YCX81/Axdr/原理图.pdf

# VBUS A4 CC1 A5 DP1 A6 DN1 A7 SBU1 A8 VBUS A9

# 防反接&防过压&缓启动

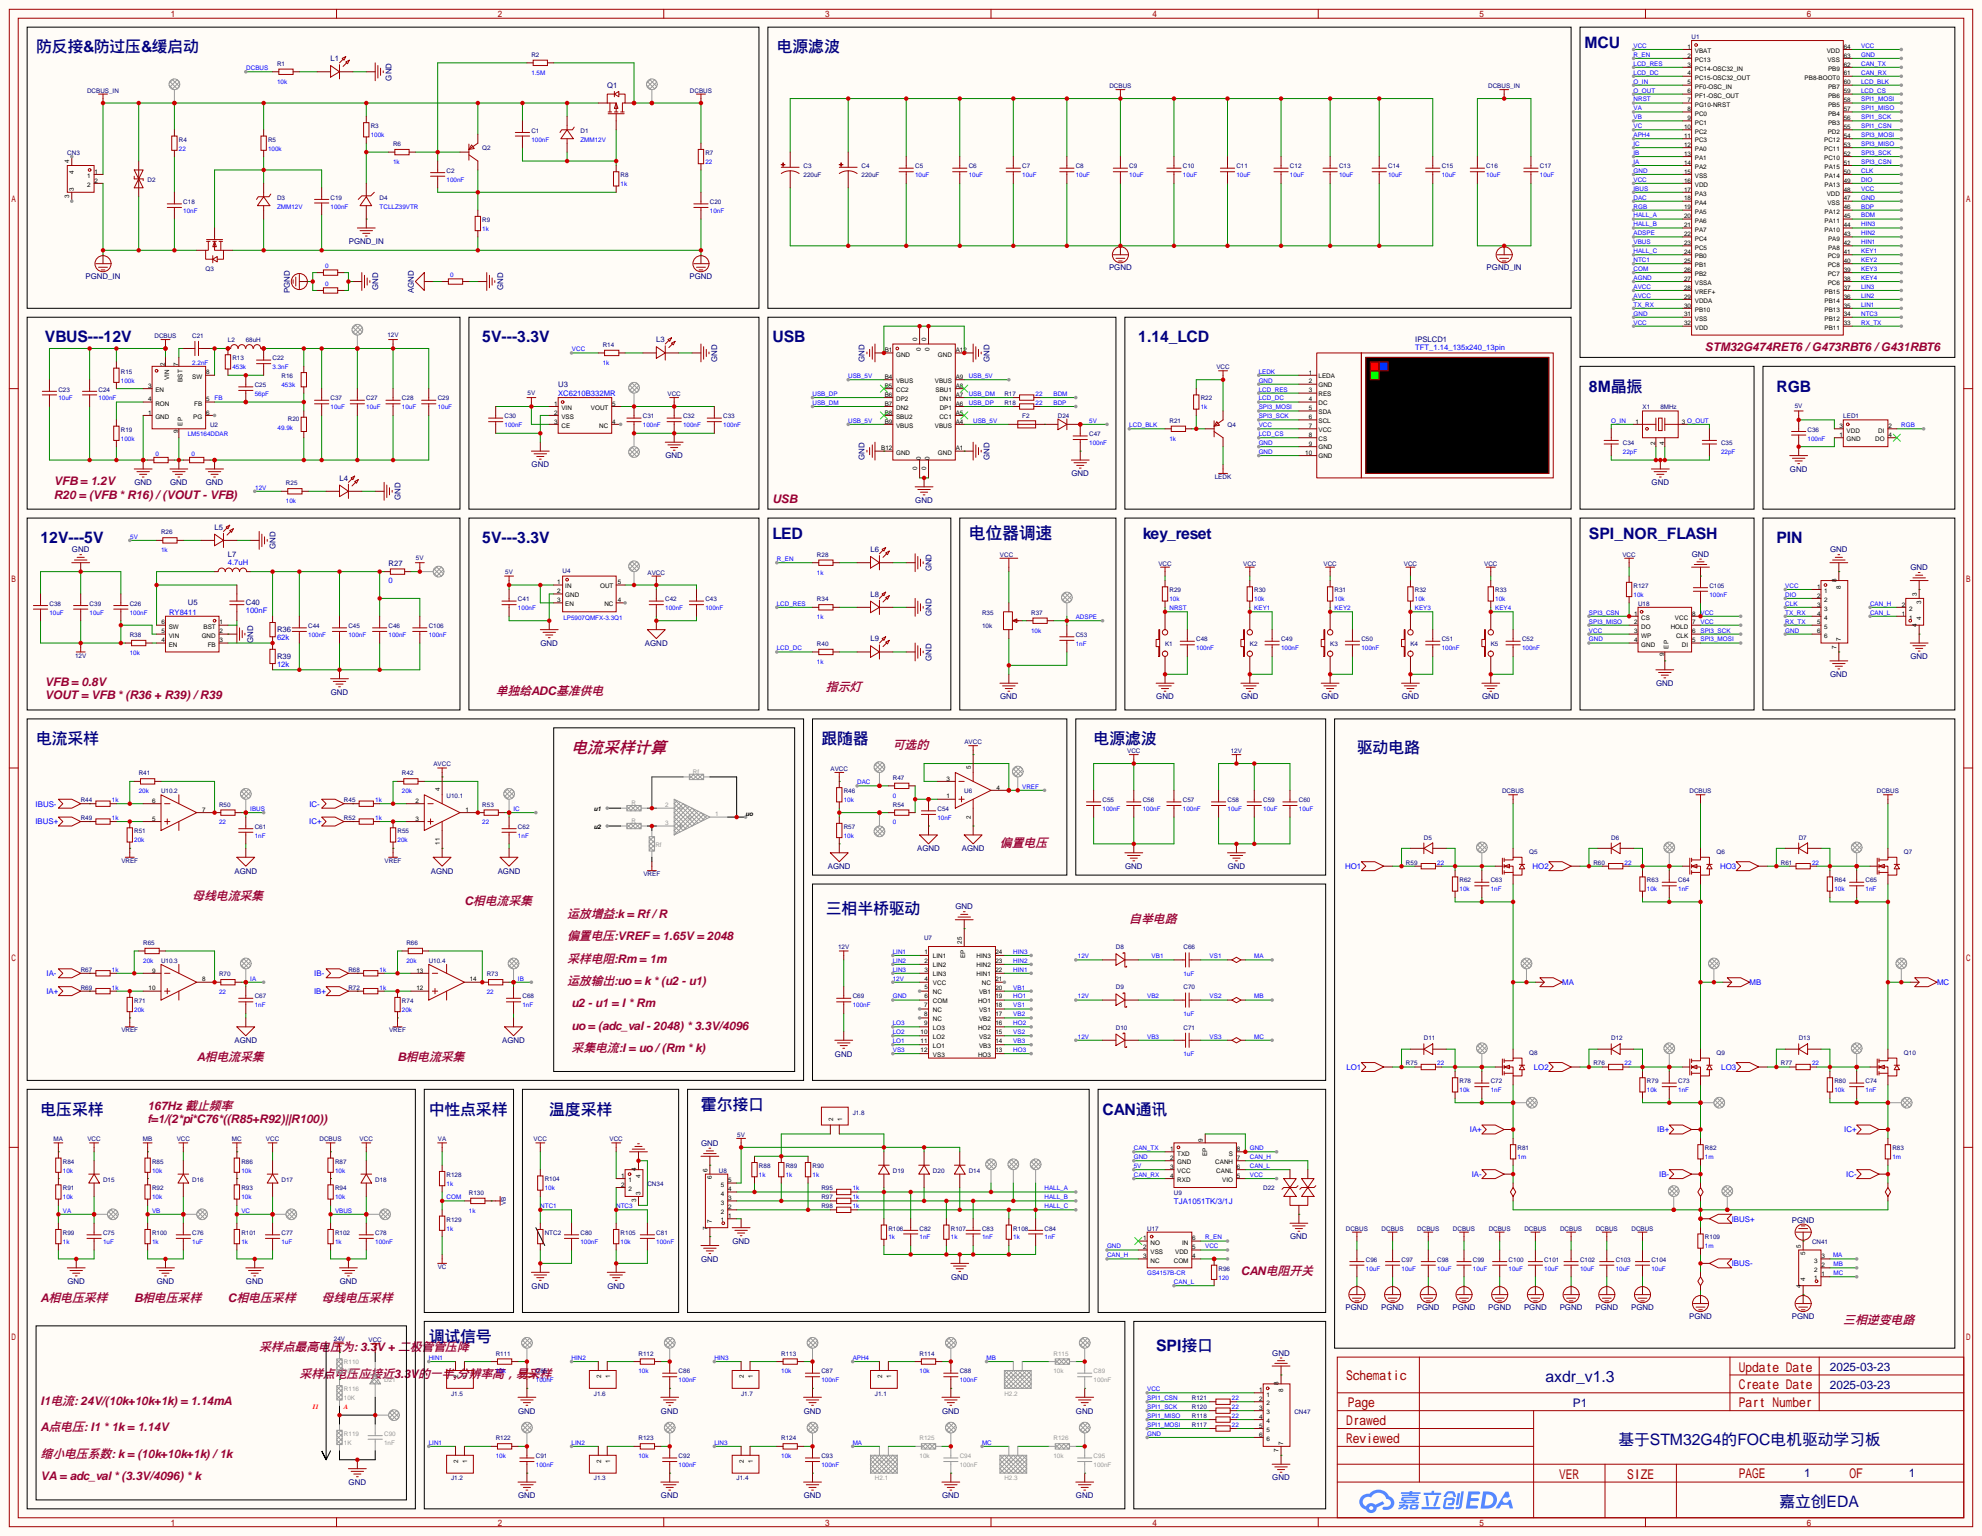
[picture p2: page 1]
