YCX81/Axdr/Core/Src/main.c

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
/* Includes ------------------------------------------------------------------*/
#include "main.h"
#include "adc.h"
#include "dma.h"
#include "fdcan.h"
#include "spi.h"
#include "tim.h"
#include "usart.h"
#include "usb_device.h"
#include "gpio.h"

/* USER CODE BEGIN Includes */
#include "foc_config.h"
#include "foc_math.h"
#include "svpwm.h"
#include "open_loop.h"
#include "foc_ctrl.h"
#include "mt6835.h"
#include "vofa.h"
#include "test_runner.h"
#include <stdio.h>
#include <string.h>
/* USER CODE END Includes */

/* USER CODE BEGIN PM */
#define IQ_STEP_HOLD_MS 3000U

/* USER CODE END PM */


void SystemClock_Config(void);
/**
  * @brief  The application entry point.
  * @retval int
  */
int main(void)
{

  /* MCU Configuration--------------------------------------------------------*/

  /* Reset of all peripherals, Initializes the Flash interface and the Systick. */
  HAL_Init();

  /* Configure the system clock */
  SystemClock_Config();

  /* Initialize all configured peripherals */
  MX_GPIO_Init();
  MX_DMA_Init();
  MX_SPI1_Init();
  MX_TIM1_Init();
  MX_TIM3_Init();
  MX_USB_Device_Init();
  MX_ADC1_Init();
  MX_ADC2_Init();
  MX_USART3_UART_Init();
  MX_FDCAN1_Init();
  MX_SPI3_Init();
  /* USER CODE BEGIN 2 */

  /* Initialize MT6835 encoder via SPI1 */
  mt6835_init(&g_encoder, 7);   /* pole_pairs: adjust to your motor */

#ifdef ENABLE_TESTS
  HAL_Delay(500);  /* wait for USB enumeration */
  test_run_all();
  while (1) { ; } /* halt after tests */
#endif

  /* Initialize FOC controller */
  foc_ctrl_init(&g_foc);

  /* Calibrate ADC zero-current offsets (PWM off, motor still) */
  HAL_ADCEx_Calibration_Start(&hadc1, ADC_SINGLE_ENDED);
  foc_ctrl_calibrate_offsets(&g_foc);

  /* === Encoder zero-point calibration ===
   * Apply Valpha > 0, Vbeta = 0 to align rotor d-axis to alpha (true elec angle = 0)
   * NOT using Vq (which would be 90 degrees off) */

  /* Start PWM manually for calibration */
  HAL_TIM_PWM_Start(&htim1, TIM_CHANNEL_1);
  HAL_TIM_PWM_Start(&htim1, TIM_CHANNEL_2);
  HAL_TIM_PWM_Start(&htim1, TIM_CHANNEL_3);
  HAL_TIMEx_PWMN_Start(&htim1, TIM_CHANNEL_1);
  HAL_TIMEx_PWMN_Start(&htim1, TIM_CHANNEL_2);
  HAL_TIMEx_PWMN_Start(&htim1, TIM_CHANNEL_3);

  /* Apply d-axis voltage directly: Valpha = 15% Vbus, Vbeta = 0 */
  {
    SvpwmOutput_t cal_pwm = svpwm_calculate(VBUS_DEFAULT * 0.15f, 0.0f, VBUS_DEFAULT);
    svpwm_apply(&cal_pwm);
  }

  /* Wait for rotor to settle at electrical angle = 0 */
  HAL_Delay(1000);

  /* Read encoder and set as zero offset */
  mt6835_update(&g_encoder);
  mt6835_set_zero(&g_encoder);

  /* Stop calibration PWM */
  HAL_TIM_PWM_Stop(&htim1, TIM_CHANNEL_1);
  HAL_TIM_PWM_Stop(&htim1, TIM_CHANNEL_2);
  HAL_TIM_PWM_Stop(&htim1, TIM_CHANNEL_3);
  HAL_TIMEx_PWMN_Stop(&htim1, TIM_CHANNEL_1);
  HAL_TIMEx_PWMN_Stop(&htim1, TIM_CHANNEL_2);
  HAL_TIMEx_PWMN_Stop(&htim1, TIM_CHANNEL_3);

  /* Current closed-loop mode with Iq step-response test */
  foc_ctrl_set_mode(&g_foc, FOC_MODE_CURRENT);
  g_foc.id_ref = 0.0f;
  g_foc.iq_ref = 0.05f;
  foc_ctrl_start(&g_foc);

  /* USER CODE END 2 */

  /* Infinite loop */
  /* USER CODE BEGIN WHILE */
  while (1)
  {
    /* USER CODE END WHILE */

    /* USER CODE BEGIN 3 */
    {
      uint32_t step_idx = (HAL_GetTick() / IQ_STEP_HOLD_MS) % 3U;

      if (step_idx == 0U) {
        g_foc.iq_ref = 0.05f;
      } else if (step_idx == 1U) {
        g_foc.iq_ref = 0.10f;
      } else {
        g_foc.iq_ref = 0.15f;
      }
    }
    /* Encoder is read in TIM1 ISR at 20kHz — do NOT call mt6835_update here
     * to avoid SPI race condition with the ISR. */

    /* VOFA+ debug output now handled via USB CDC in TIM1 ISR (vofa_send_from_isr) */
  }
  /* USER CODE END 3 */
}

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
/* USER CODE BEGIN 4 */

/* TIM1 update interrupt callback - called at PWM frequency (20kHz) */
void HAL_TIM_PeriodElapsedCallback(TIM_HandleTypeDef *htim)
{
  if (htim->Instance == TIM1) {
    mt6835_update(&g_encoder);
    foc_ctrl_update(&g_foc);
    vofa_send_from_isr();
  }
}

/* USER CODE END 4 */
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
