YCX81/Axdr/AxDr.ioc

Mcu.UserName=STM32G431RBTx
PA0.Signal=ADC1_IN1
PA1.Signal=ADC1_IN2
PA10.Signal=S_TIM1_CH3
PA11.Signal=USB_DM
PA12.Signal=USB_DP
PA13.Signal=SYS_JTMS-SWDIO
PA14.Signal=SYS_JTCK-SWCLK
PA15.GPIO_Label=SPI3_CS
PA15.Signal=GPIO_Output
PA2.Signal=ADC1_IN3
PA3.Signal=ADC1_IN4
PA6.Signal=ADC2_IN3
PA7.Signal=ADC2_IN4
PA8.Signal=S_TIM1_CH1
PA9.Signal=S_TIM1_CH2
PB1.Signal=ADC1_IN12
PB10.Signal=USART3_TX
PB11.Signal=USART3_RX
PB12.Signal=ADC1_IN11
PB13.Signal=TIM1_CH1N
PB14.Signal=TIM1_CH2N
PB15.Signal=TIM1_CH3N
PB3.Signal=SPI1_SCK
PB4.Signal=SPI1_MISO
PB5.Signal=SPI1_MOSI
PB6.GPIO_Label=LCD_CS
PB6.Signal=GPIO_Output
PB7.GPIO_Label=LCD_BLK
PB7.Signal=GPIO_Output
PB8-BOOT0.Signal=FDCAN1_RX
PB9.Signal=FDCAN1_TX
PC0.Signal=ADC2_IN6
PC1.Signal=ADC2_IN7
PC10.Signal=SPI3_SCK
PC11.Signal=SPI3_MISO
PC12.Signal=SPI3_MOSI
PC13.GPIO_Label=R_EN
PC13.Signal=GPIO_Output
PC14-OSC32_IN.GPIO_Label=LCD_RES
PC14-OSC32_IN.Signal=GPIO_Output
PC15-OSC32_OUT.GPIO_Label=LCD_DC
PC15-OSC32_OUT.Signal=GPIO_Output
PC2.Signal=ADC2_IN8
PC4.Signal=ADC2_IN5
PC5.Signal=ADC2_IN11
PC6.Signal=GPIO_Input
PC7.Signal=GPIO_Input
PC8.Signal=GPIO_Input
PC9.Signal=GPIO_Input
PD2.GPIO_Label=SPI1_CSN
PD2.Signal=GPIO_Output
PF0-OSC_IN.Signal=RCC_OSC_IN
PF1-OSC_OUT.Signal=RCC_OSC_OUT
