YCX81/Axdr/(commit log)

2026-03-18 feat: initial FOC motor controller for STM32G431
    - FOC with Clarke/Park transforms, SVPWM (min-max zero-sequence injection)
    - AS5600 encoder via software I2C, auto zero-point calibration
    - Current loop with PI controllers (d/q axis)
    - Open-loop, voltage, and closed-loop current modes
    - 256-point sine LUT in CCMRAM with sincos optimization
    - VOFA+ JustFloat debug output via USB CDC
    - ADC injected channels for 3-phase current sensing
2026-03-18 docs: add software architecture and control flow details to README
2026-03-18 fix: ADC current sampling, USB CDC debug output and SVPWM duty channels
    - Fix TIM1_CH4 ADC trigger: set CCR4 = Period-1 so falling edge
    fires at PWM center for accurate current measurement
    - Fix ADC offset calibration: temporarily switch injected group
    to software trigger during calibration (TIM1 not running yet)
    - Switch debug output from UART CSV to USB CDC JustFloat protocol
    via vofa_send_from_isr() called in TIM1 update ISR at 20kHz
    - Add SVPWM duty cycle channels (duty_a/b/c) to VOFA+ output
    - Use open-loop mode at 10Hz/30% Vbus for waveform verification
    - Update README with SVPWM saddle wave screenshot and docs
    [foc_ctrl.c, foc_ctrl.h, main.c, vofa.c, vofa.h]
2026-03-19 feat: replace AS5600/soft-I2C with MT6835 over SPI1
    - Remove soft_i2c and as5600 driver, replace with mt6835 SPI driver
    - MT6835 reads 21-bit angle via SPI1 (Mode 3, 8-bit, software CS on PD2)
    - Add Test/ folder with on-target SPI and MT6835 verification tests
    - Add MT6835 mechanical angle and raw count to VOFA+ channels (ch9, ch10)
    - Set VBUS_DEFAULT to 29.1V to match actual supply
    - Reduce open-loop amplitude from 30% to 15% to limit motor heating
    [AxDr.ioc, foc_config.h, foc_ctrl.c, main.c, mt6835.c, mt6835.h, test_mt6835.c]
2026-03-22 feat: current closed-loop with bus current sensing, ADC/PWM channel fix, and ISR encoder read
    - Add bus current sampling on ADC1_CH4 (PA3) as injected rank 4
    - Fix ADC JDR-to-phase mapping (JDR3=Ia, JDR2=Ib, JDR1=Ic) to match schematic
    - Add MOTOR_PWM_BC_SWAP / MOTOR_ADC_BC_SWAP compile switches for phase wiring
    - Add first-order LPF (alpha=0.20) on phase currents and Id/Iq
    - Lower PI gains (Kp=0.020, Ki=0.0004) and output limit (5V) for safe bringup
    - Move mt6835_update() into TIM1 ISR; optimize SPI to direct register access
    - Set TIM1 RepetitionCounter=1 for 20kHz update rate in center-aligned mode
    - Shift ADC trigger point (CCR4=Period-325) to avoid switching noise
    - Switch startup mode t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
    [AxDr.ioc, adc.c, foc_config.h, foc_ctrl.c, foc_ctrl.h, main.c, mt6835.c]
2026-03-22 fix: clean up stale comments, encoding errors, and indentation
    - Fix garbled UTF-8 em-dash in main.c comment
    - Update ADC trigger comment to match actual CCR4 offset (Period-325)
    - Fix indentation on __HAL_TIM_SET_COMPARE and mt6835.c offset_raw
    - Remove outdated debug comments (VOLTAGE mode step, ol_amplitude)
    - Update vofa.c frame size comment to reflect 20 channels
    [foc_ctrl.c, main.c, mt6835.c, vofa.c]
